philipnisevich/xrpad/xr_console/secrets.example.h

#pragma once

// Wi-Fi network the XR18 is on (your router, or the XR18's own access point).
#define WIFI_SSID     "your-wifi-name"
#define WIFI_PASSWORD ""  // empty for an open network (e.g. the XR18 access point)

// Leave empty to auto-discover the XR18 on the network.
// Set it (e.g. "192.168.1.50") if discovery doesn't find the mixer.
#define XR18_IP ""
