philipnisevich/xrpad/(commit log)

2026-10-10 XR18 master mute button on ESP32-S3
    Toggles XR18 main LR mute over Wi-Fi/OSC with a button on GPIO5 and
    mirrors the state on the onboard LED. Subscribes with /xremote so app
    changes are reflected, ignores stale replies, and resends unconfirmed
    presses.
    Claude-Session: https://claude.ai/code/session_01DYaFp1Htun8MgRebENkT5V
2026-10-10 Add encoder + OLED fader knob for XR18
    New xr_fader_knob sketch: a rotary encoder moves the selected channel's
    fader (0.1 dB per click, 0.5 dB when turned quickly, 10 dB when spun),
    and pressing it cycles CH 1-16, AUX and MAIN. A 128x64 SSD1306 shows the
    channel number, name and level, plus a bar for every strip's fader.
    Clicks are counted in the encoder interrupt when it returns to rest, so
    step size uses real click timing rather than the display-bound loop rate.
    Names and faders are re-read every 8 s and mixer echoes are ignored while
    turning.
    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
2026-10-10 Stop serial logging from freezing the fader knob display
    With USB connected but no serial monitor reading, each print blocked for
    up to 100 ms waiting for a reader, so the display lagged by a second or
    more while turning. Drop serial output instead of waiting.
    Also restores the 10 dB step for very fast spins.
    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
2026-10-10 Add slide fader controller with touch-gated pickup
    New xr_slide_fader sketch: the encoder selects CH 1-16, AUX or MAIN and
    a 10k linear slide fader on G07 sets that channel's level. Because the
    fader isn't motorized it uses pickup: it only takes over once moved past
    the channel's current level, with an arrow and a position marker on the
    OLED until then. Moves from the app release the pickup.
    The fader only sends while its touch track (G10) is touched, with a
    deadband on the ADC reading, so a resting fader never jitters the mixer.
    Touch thresholds come from measured readings (idle +-0.2%, finger
    +170-330%) and the baseline is taken at boot.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
    [secrets.example.h, xr_slide_fader.ino]
2026-10-10 Add motorized fader controller
    New xr_motor_fader sketch: the fader motor (TC1508A on G12/G11, 20 kHz
    PWM) drives the fader to the selected channel's level on channel change
    and when the app moves that channel. Motor control runs in its own 1 kHz
    task that owns the ADC, since display redraws stall the main loop ~35 ms.
    Touching the fader releases the motor and falls back to pickup; a stall
    timeout and wrong-direction check stop the motor.
    The touch baseline now drops to any lower reading immediately, since the
    sensor reads high for a while after boot.
    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
    [secrets.example.h, xr_motor_fader.ino]
2026-10-10 Calibrate motor fader at boot and drive into end stops
    At boot the motor drives into both end stops and measures them, and the
    fader range is set from those readings with a 1.5% buffer at each end, so
    -inf and +10 dB map to reachable points. Moves to -inf/+10 dB drive at full
    power into the end stop until the fader stops instead of aiming for a point
    the motor can't quite reach on 5 V. Short moves that stall get a power
    kick that ramps up until the fader moves.
    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
    [xr_motor_fader.ino]
2026-10-11 Add TFT console UI for the motorized fader controller
    New xr_console sketch: the motorized fader controller plus a 4.0" 480x320
    ST7796 SPI TFT with XPT2046 touch. For the selected channel it shows the
    name and colour, mute/solo buttons, a segmented input meter beside the
    fader scale, the EQ frequency response (4 bands + low cut, computed from
    the mixer's parameters), a scrolling input history with gate/compressor
    thresholds, preamp gain/48V/polarity/LR, pan and bus/FX sends, plus an
    overview of all 18 strips. Tapping mutes, solos or selects a channel.
    The UI runs as its own task on core 0, snapshots shared state under a
    mutex and redraws only panels whose content changed. The board fetches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
2026-10-11 Add Wi-Fi picker, settings and mixer sync screen to the console
    Wi-Fi is now chosen on the TFT instead of hard-coded: at boot the board
    scans and joins the most recently used saved network in range (up to 5
    are remembered), otherwise it shows a network picker with signal, lock
    and saved/connected tags, and an on-screen keyboard for passwords. A gear
    in the header (and on the status screens) opens settings to change
    network or recalibrate the touchscreen.
    After the mixer is found, a sync screen shows real loading progress
    (names, faders and mutes of every strip, the selected channel's details,
    meters) with a checklist, then switches to the console. Lost UDP replies
    are re-requested in repair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
2026-10-11 Redesign console UI with per-section editing pages
    The encoder can now edit any channel setting: tap a control to point the
    knob at it (fader, gain and pan on the overview; everything else on its
    page), turn to adjust (fast spins take bigger steps), tap again or the
    header card to stop, and press the encoder to reset it to its default.
    On/off settings (48V, invert, LR, low cut, EQ/gate/comp) toggle on tap.
    The overview drops the input history for gate and compressor curve
    thumbnails with a live input dot; EQ, gate, compressor, sends and preamp
    each open a full page: EQ curve with band/low-cut selection and
    type/freq/gain/Q, gate and compressor transfer curves with all timing
    and level setti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
    [ui.h, xr_console.ino]
2026-10-11 Add home screen with mixer-wide tabs and channel insert FX
    New default view after sync: a tabbed home screen with channel banks
    1-8 and 9-16 (source, insert, 48V/EQ/gate/comp/solo badges, meter,
    fader, pan, mute), returns (aux, FX 1-4, main), buses and FX sends,
    DCAs with mute groups and headphones, a 40-meter bridge with peak hold,
    FX slots (effect type, send/return levels and which channels insert
    them) and mixer info (name, IP, network, snapshot, automix, links,
    settings). Mutes and mute groups toggle on tap; bus, FX, DCA and
    headphone levels can be adjusted with the encoder. The channel view
    gets a home button.
    Channels can now insert an effect: an FX badge in the preamp panel
    opens an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
2026-10-11 Add 8-fader board firmware and fader banks
    New xr_fader_board sketch for a second ESP32-S3 that runs up to 8
    motorized faders: wipers on G1-G8, TC1508A drivers (IN1 PWM G9-G16,
    IN2 direction), MPR121 touch on I2C (falls back to detecting a hand by
    motion), boot calibration into both end stops, and the console's motor
    control per fader. It talks to the main board over UART with a small
    text protocol (targets in, positions and touch out every 20 ms).
    The console links to it on G13/G14. The home tabs 1-8, 9-16, RTN, BUS
    and DCA choose the fader bank: each fader is sent the level of what
    it's assigned to, follows changes from the app, and a hand on a fader
    sets that level (and selects the chann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
2026-10-11 Fader board: native touch on G5-G8 for up to 4 faders
    Temporary setup without an MPR121: with 4 faders or fewer, the wiper
    pins of faders 5-8 (G5-G8) are free and touch-capable, so the touch
    tracks of faders 1-4 go there. Uses the console's touch detection
    (baseline taken at boot, on at +15%, off at +8%). NATIVE_TOUCH = false
    switches back to the MPR121 for 8 faders.
    Claude-Session: https://claude.ai/code/session_01Dy379e9HDb29RVw6xZtnrM
2026-10-11 Fader board: move the main-board link to G47/G48
    The LCKFB board doesn't break out G43/G44. In the 4-fader native-touch
    setup the link uses TX G48 / RX G47; with the MPR121 on G47/G48 it
    moves to TX G45 / RX G46.
    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
    [xr_fader_board.ino]
2026-10-11 Fader board: motor task, self-correcting direction, debug tools
    Motor control runs in its own task on core 0 every millisecond, so slow
    touch reads and link traffic no longer make faders overshoot and hunt.
    Calibration also runs there (from setup() the motors didn't move), and
    it detects each motor's wiring direction; a move that runs the wrong way
    reverses that motor and carries on. Re-sent targets don't nudge a fader
    that's already on them.
    Debug output (temporary): link/position/touch status every 2 s on both
    boards, and USB commands on the fader board: M <n> motor test,
    C recalibrate, X motors off/on.
    Claude-Session: https://claud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
    [xr_console.ino, xr_fader_board.ino]
2026-10-11 Fader board: reliable calibration, no clicking, hand moves without touch
    - Calibrate one fader at a time: all motors stalling at full power
    together pulled the supply down and the drivers cut out.
    - A fader that fails calibration is disabled instead of being driven
    blind (that was the once-a-second click).
    - Only a changed target moves a fader; re-sent targets are ignored, and a
    target that couldn't be acted on yet isn't recorded as done.
    - After braking, a fader that coasted past its target gets up to three
    gentle corrections.
    - Hands are also detected by the fader moving while its motor is idle,
    so faders work when the touch pads don't; native touch pads with
    implausible readin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
    [xr_fader_board.ino]
2026-10-11 Move linked faders together smoothly
    Moving a fader on a stereo-linked channel used to make its partner lurch:
    the mixer's link updates arrived late and in steps, and each one
    restarted the partner's move from scratch (full-power start, brake,
    correction).
    - Main board: a hand move on a linked channel sets the partner's level
    immediately from the same position and ignores the mixer's echoes
    while it's moving.
    - Fader board: targets arriving within 300 ms of each other are followed
    as a stream - the motor keeps steering towards the newest one without
    restarting, braking or correcting, then settles precisely on the last.
    Claude-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
    [xr_console.ino, xr_fader_board.ino]
2026-10-11 Smooth fader motion on both boards; reliable touch on the fader board
    Motors now run drive/brake (slow decay) both ways, so speed follows power
    evenly from ~30%. Moves follow a glide (accelerate, cruise, ease in, brief
    brake at the end), and streams of targets from the app, encoder or a linked
    partner play back as one steady motion instead of start-stop lurches.
    Fader board touch: the ESP32 touch peripheral never started scanning, so
    pads are now timed by charging them through the pull-up, left floating
    between readings (holding them low stalled the motors), with a high
    threshold and debouncing.
    Adds USB debug commands for measuring motion (speed sweep, test moves and
    streams, 2 ms recordi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
    [xr_console.ino, xr_fader_board.ino]
2026-10-12 Second fader board for faders 5-8
    The main board now talks to up to two fader boards: the first on G13/G14
    for bank faders 1-4 (or all 8 with an MPR121), a second on G1/G2 for bank
    faders 5-8. Both run the same fader board firmware; the main board maps
    their fader numbers and merges positions and touch for the UI.
2026-10-13 Fader board: all 8 faders on one board with MPR121 touch
    FADERS = 8 with touch on an MPR121: faders 1-4 on ELE0-ELE3, 5-8 on
    ELE5-ELE8. The MPR121 now starts with auto-setup on: with it "off", the
    Adafruit library still leaves auto re-tuning enabled with no targets, which
    fails and leaves every input reading near zero.
    Debug output shows each pad's reading and baseline, logs touches, and "Q"
    over USB sets the MPR121 charge current and time.
    [xr_fader_board.ino]
2026-10-13 Fader board: all-together calibration and a power-up show
    Calibration drives every fader into its ends together, with a soft power
    ramp, 70% power and each fader letting go as soon as it stops, so the
    supply copes. Afterwards a short show plays at power-up: a wave rolls
    across the faders, calms into a line, and they drop like dominoes before
    going to their levels.
    Motors are switched off first thing in setup(). G39 (fader 5's IN2) is
    pulled high during boot, which ran fader 5 up; a 10k pull-down from G39 to
    GND fixes that.
    [xr_fader_board.ino]
2026-10-13 Add README with wiring diagrams; bring sketch headers up to date
    The README covers the hardware list, main console and fader board wiring
    (pin diagrams and tables, motor drivers, MPR121, link, pull-downs), power,
    building and flashing, first start, usage, how the faders move, the board
    link protocol, USB debug commands and troubleshooting. The sketch headers
    now match the single 8-fader board with MPR121 touch.
2026-10-13 Fader display: label, name, level and mute/solo on an OLED
    A 0.96" SSD1306 on the fader board's I2C bus (with the MPR121) shows what
    fader 1 is assigned to: label and level in dB along the top, the name as
    large as fits, and MUTE and SOLO indicators. The main board sends each bank
    fader's label, name, mute and solo ("N" lines) when they change and with the
    periodic re-send. The screen goes out one 8-pixel row per loop pass, so
    touch reads on the shared bus aren't held up. A TCA9548A multiplexer will
    later give each fader its own display.
2026-10-28 Fader board: 8 multiplexed displays, smoother remote moves; README diagram
    - One SSD1306 OLED per fader on a TCA9548A (0x70), display n on channel
    n-1; screens go out a row per loop pass so touch reads aren't held up.
    A single OLED straight on the bus still works as fader 1.
    - Remote target streams play back 80 ms behind real time, interpolated,
    so uneven link timing doesn't make faders stutter.
    - README: short intro, the complete wiring diagram (docs/wiring.png),
    fader display wiring and the N line in the protocol table.
    [xr_fader_board.ino]
